lty1993/SilentBotStep/Release/1/PCBA-SilentBotStep-DEFAULT-A.1/PCB Print/Composite Drawing.PDF

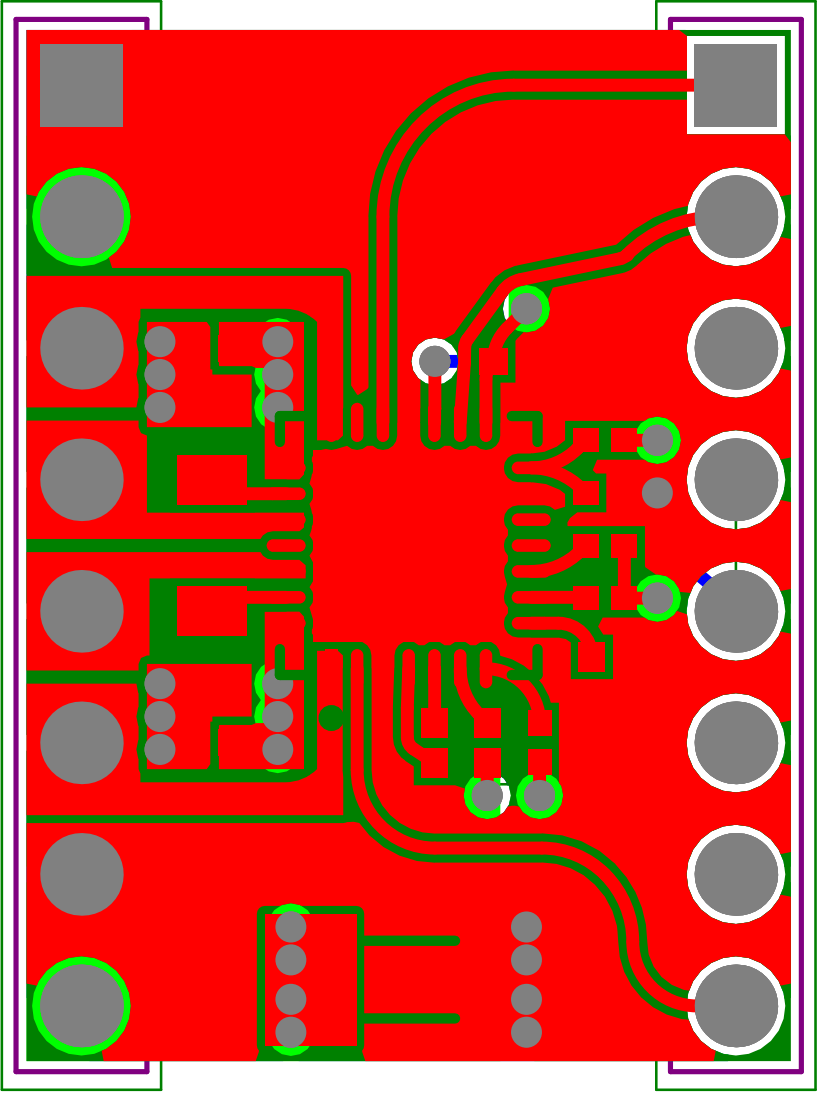
[picture p1: page 1]
