lty1993/SilentBotStep/Release/1/PCBA-SilentBotStep-DEFAULT-A.1/Schematic Print/Schematic Prints.PDF

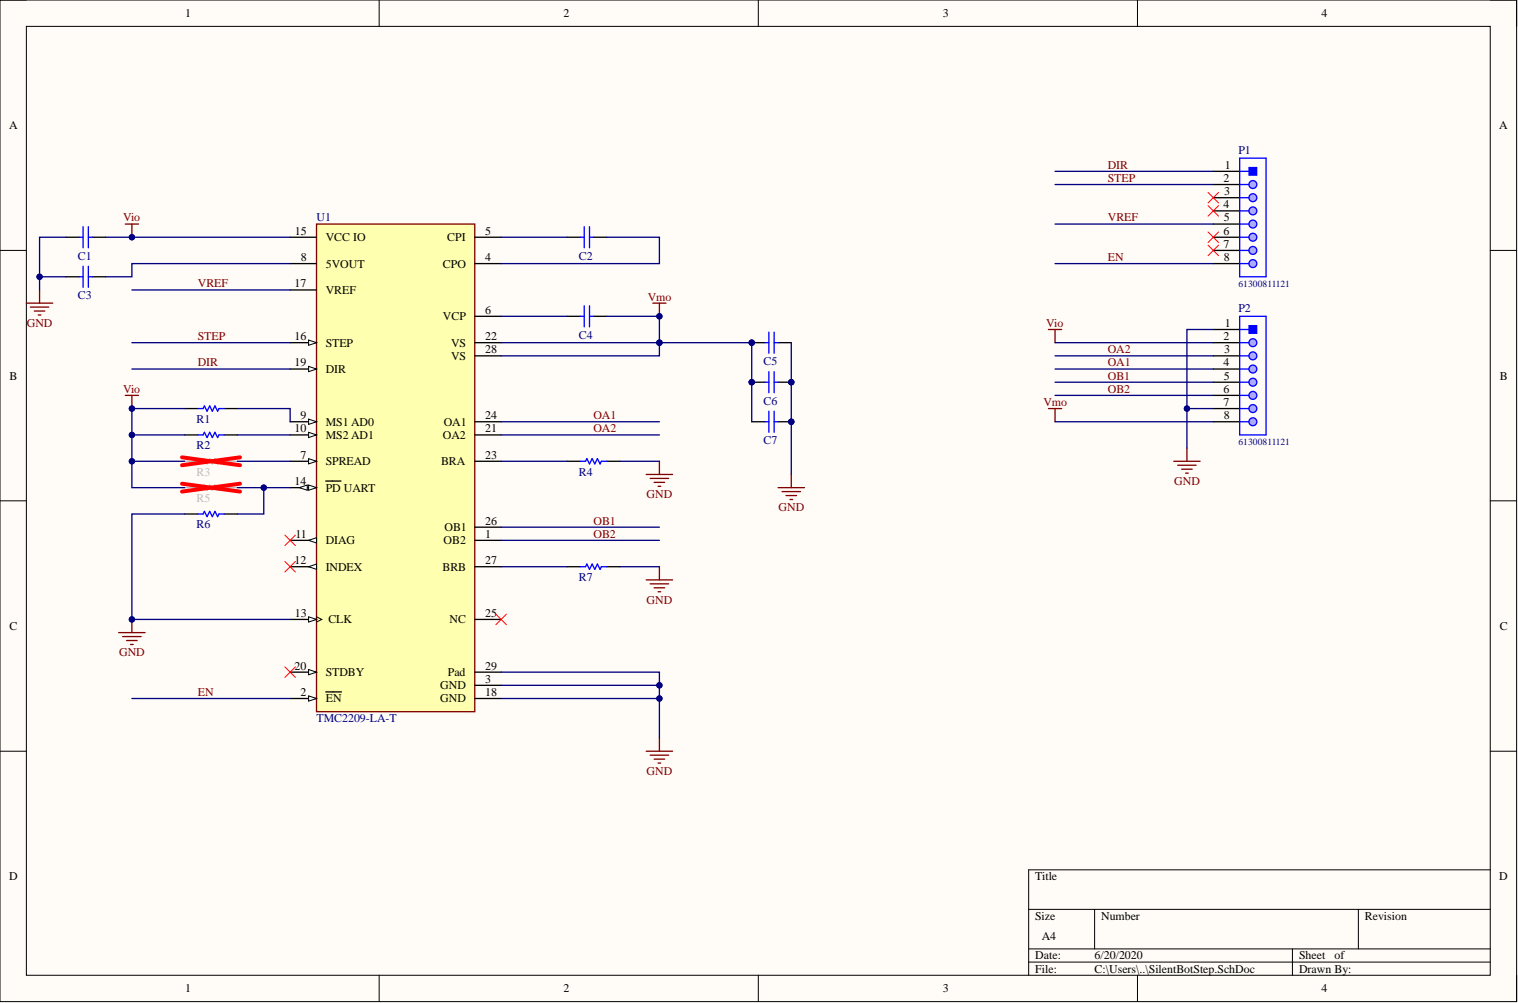
[picture p2: page 1]

STDBY 20 STEP 16 | OA 2
