lty1993/SilentBotStep/Release/2/PCBA-SilentBotStep-DEFAULT-A.2/PCBDrawing/Draftsman.PDF

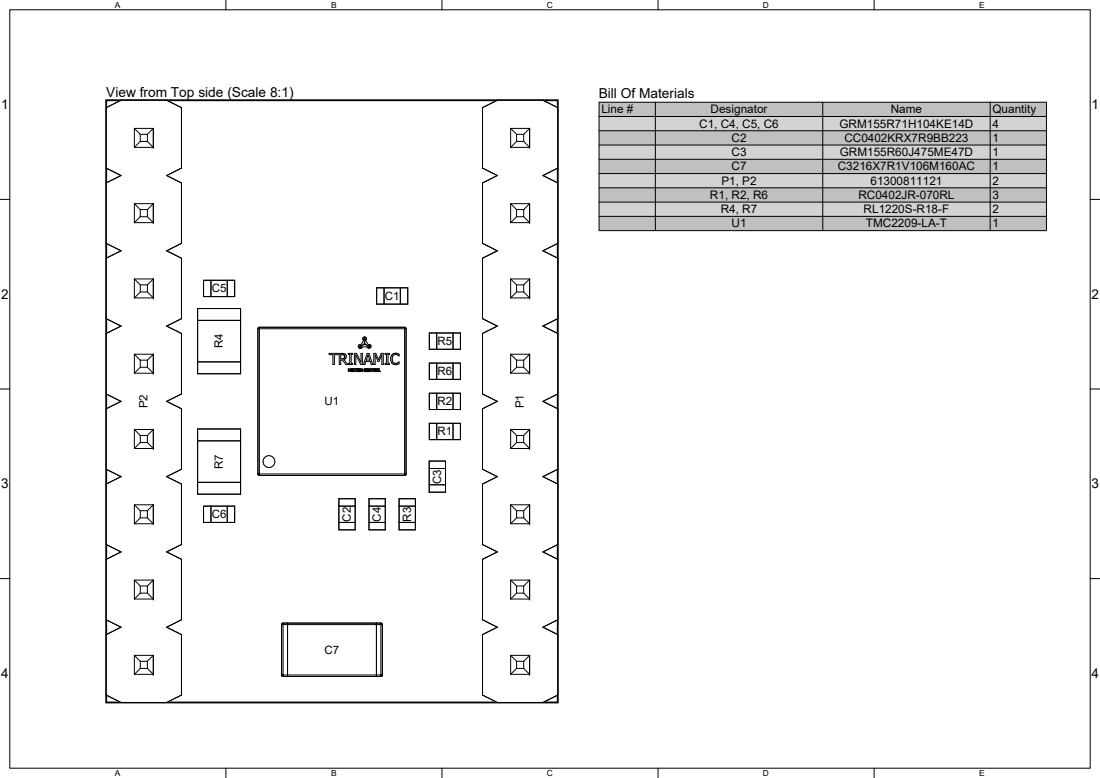
[picture p3: page 1]

View from Top side (Scale 8:1)

Line # | Designator | Name | Quantity

C1, C4, C5, C6 | GRM155R71H104KE14D | 4
C2 | CC0402KRX7R9BB223 | 1
C3 | GRM155R60J475ME47D | 1
C7 | C3216X7R1V106M160AC | 1
P1, P2 | 61300811121 | 2
R1, R2, R6 | RC0402JR-070RL | 3
R4, R7 | RL1220S-R18-F | 2
U1 | TMC2209-LA-T | 1
