lty1993/SilentBotStep/Release/2/PCBA-SilentBotStep-DEFAULT-A.2/Schematic Print/Schematic Prints.PDF

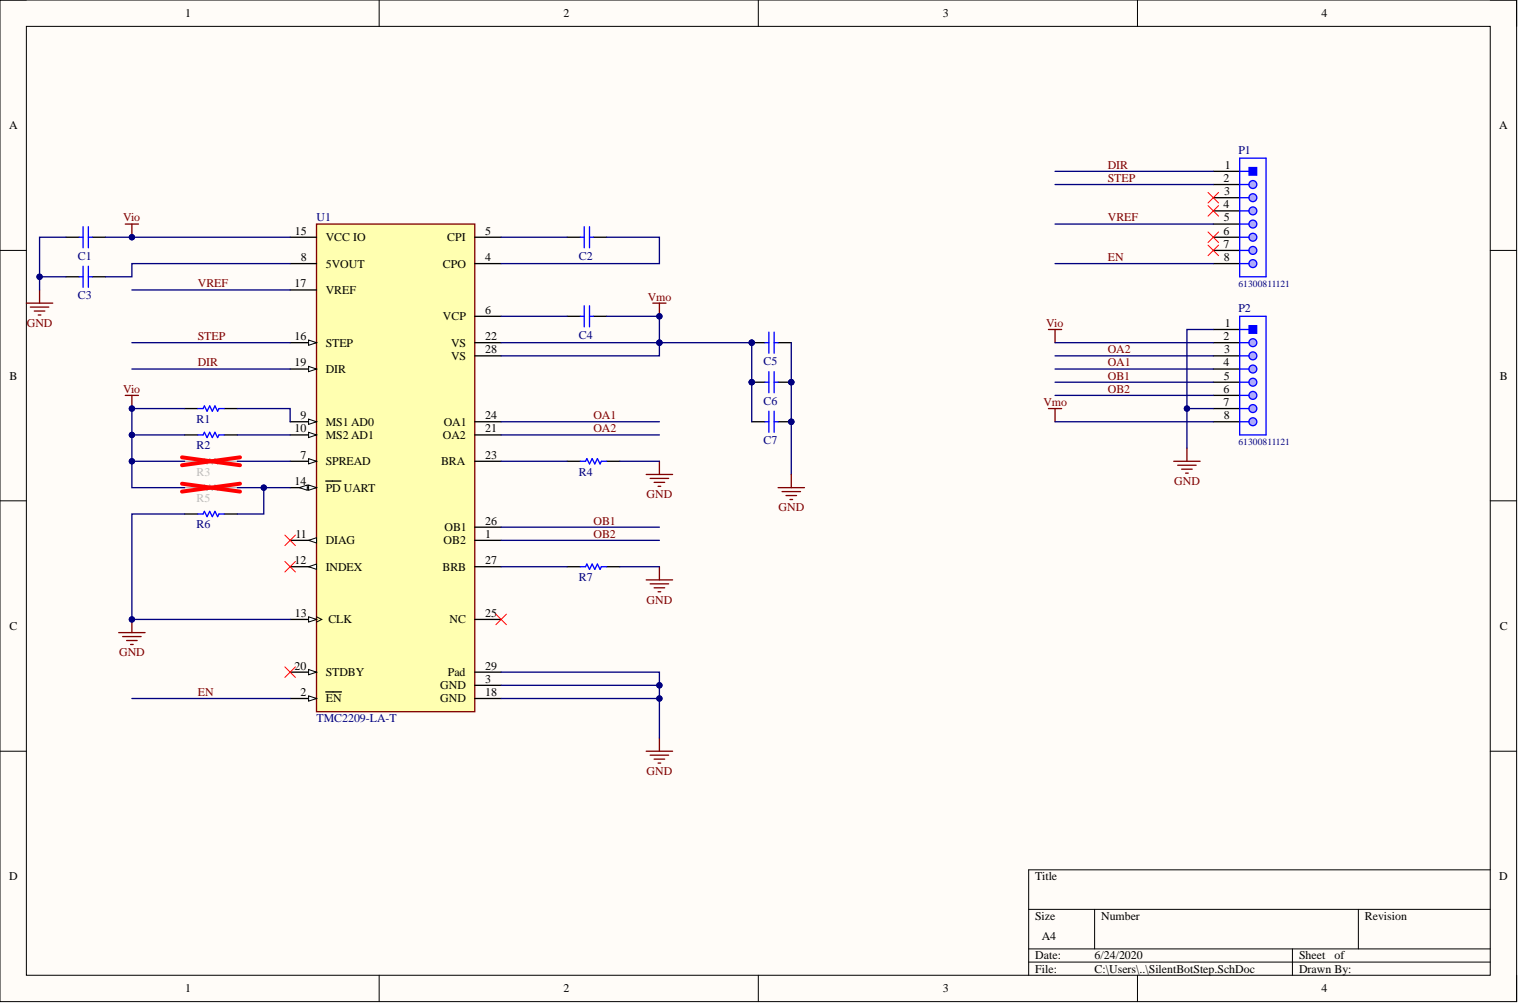
[picture p4: page 1]

STDBY 20 STEP 16 | OA 2
