lty1993/SilentBotStep/Release/3/PCBA-SilentBotStep-DEFAULT-A.3/Schematic Print/Schematic Prints.PDF

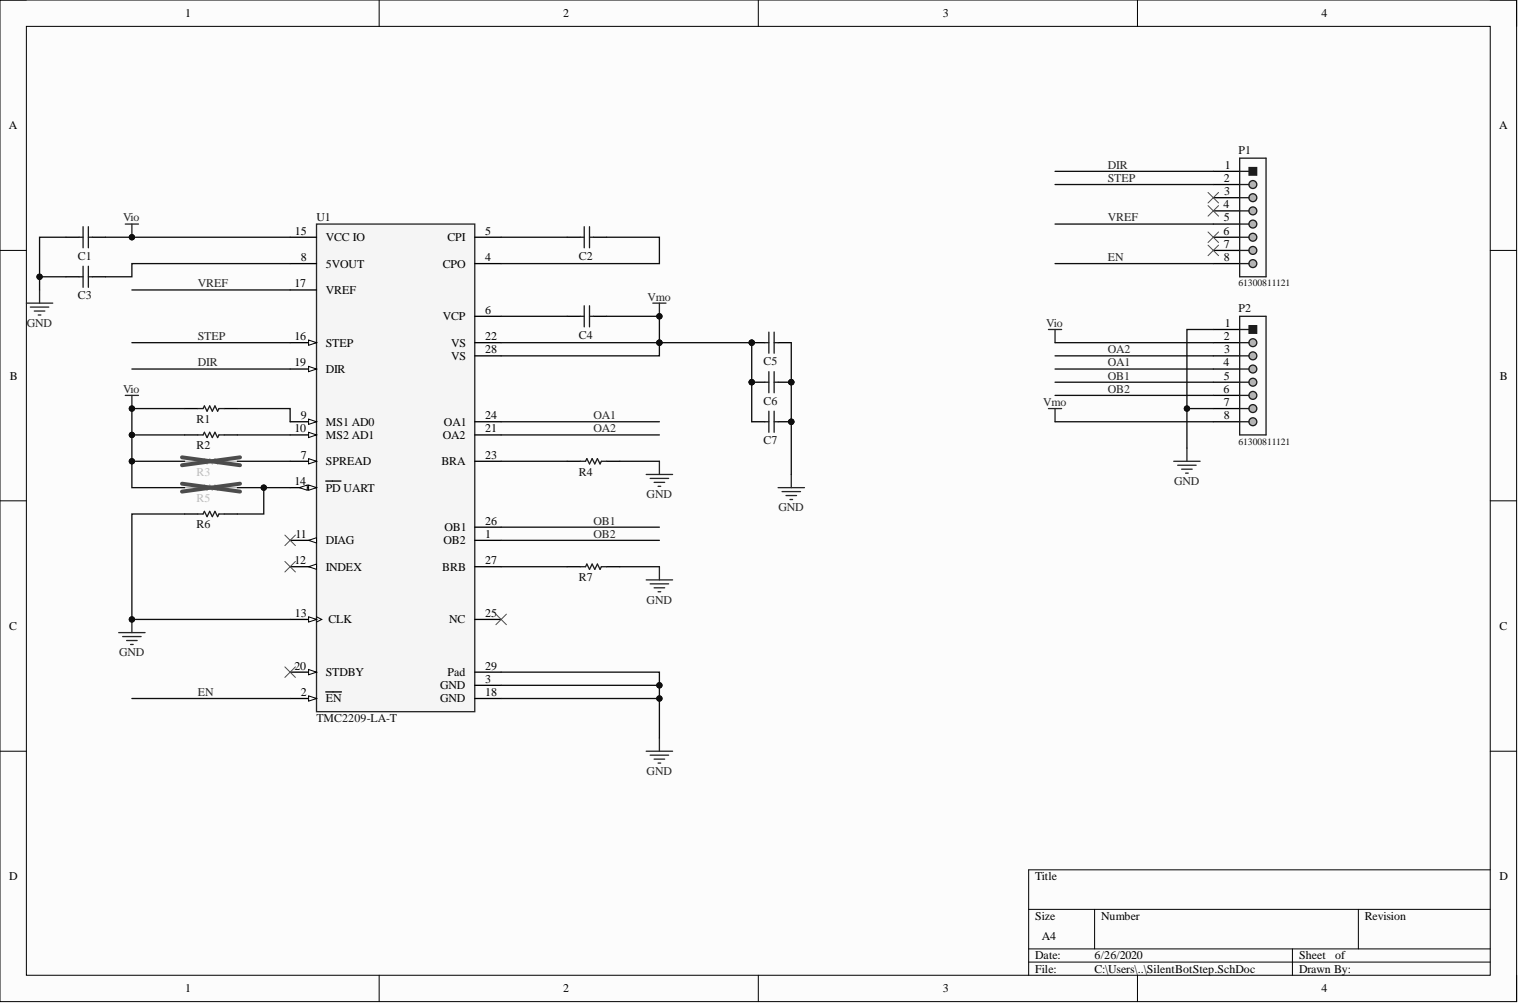
[picture p5: page 1]

1 8
