lty1993/SilentBotStep/(list of files, drawings)

Other design files:
Release/1/SRC-SilentBotStep-A.1/SilentBotStep.PcbDoc
Release/1/SRC-SilentBotStep-A.1/SilentBotStep.PrjPcb
Release/1/SRC-SilentBotStep-A.1/SilentBotStep.SchDoc
Release/2/SRC-SilentBotStep-A.2/SilentBotStep.PcbDoc
Release/2/SRC-SilentBotStep-A.2/SilentBotStep.PrjPcb
Release/2/SRC-SilentBotStep-A.2/SilentBotStep.SchDoc
Release/3/SRC-SilentBotStep-A.3/SilentBotStep.PcbDoc
Release/3/SRC-SilentBotStep-A.3/SilentBotStep.PrjPcb
Release/3/SRC-SilentBotStep-A.3/SilentBotStep.SchDoc
