lty1993/SilentBotStep/(commit log)

2020-06-19 Adding release 1 design file
    [Bill of Materials-SilentBotStep(Default).csv, Pick Place for SilentBotStep(Default).csv, SilentBotStep.PcbDoc, SilentBotStep.PrjPcb, SilentBotStep.SchDoc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]
2020-06-19 Release 2: 1. PCB: Change tracewidth/spacing from 4mil/4mil to 6mil/6mil 2. PCB: Change VIA from 0.2mm/0.45mm to 0.3mm/0.6mm
    [Bill of Materials-SilentBotStep(Default).csv, Bill of Materials-SilentBotStep.csv, Pick Place for SilentBotStep(Default).csv, Pick Place for SilentBotStep.csv, SilentBotStep.PcbDoc, SilentBotStep.PrjPcb, SilentBotStep.SchDoc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]
2020-06-19 Removing unused doc
    [Bill of Materials-SilentBotStep.csv, Pick Place for SilentBotStep.csv]
2020-06-25 Release 3
    [Bill of Materials-SilentBotStep(Default).csv, Pick Place for SilentBotStep(Default).csv, SilentBotStep.PcbDoc, SilentBotStep.PrjPcb, SilentBotStep.SchDoc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]
